ultimachine/HE280PCB/ProjectOutputs/Report Board Stack/HE280PCB_6a.xls

Board Stack Report
Stack Up |  | Layer Stack
Layer | Board Layer Stack | Name | Material | Thickness | Constant
1 |  | Top Paste, Top Paste
2 |  | Top Overlay, Top Silk
3 |  | Top Solder, Top Mask | Solder Resist | 0.40mil | 3.5
4 |  | Top Layer, Top | Copper | 1.40mil
5 |  | Dielectric 1 | FR-4 | 58.00mil | 4.8
6 |  | Bottom Layer, Bottom | Copper | 1.40mil
7 |  | Bottom Solder, Bot Mask | Solder Resist | 0.40mil | 3.5
8 |  | Bottom Overlay, Bot Silk
9 |  | Bottom Paste, Bot Paste
 | Height : 61.60mil
