ultimachine/HE280PCB/Panels/ProjectOutputs/Report Board Stack/HE280PCB-panel_v6a.xls

Board Stack Report
Stack Up |  | Layer Stack
Layer | Board Layer Stack | Name | Material | Thickness | Constant
1 |  | Top Paste
2 |  | Top Overlay
3 |  | Top Solder | Solder Resist | 0.40mil | 3.5
4 |  | Top Layer | Copper | 1.40mil
5 |  | Dielectric1 | FR-4 TG170 | 58.00mil | 4.2
6 |  | Bottom Layer | Copper | 1.40mil
7 |  | Bottom Solder | Solder Resist | 0.40mil | 3.5
8 |  | Bottom Overlay
9 |  | Bottom Paste
 | Height : 61.60mil
