ultimachine/HE280PCB/Panels/ProjectOutputs/HE280PCB-panel_v5d.PDF

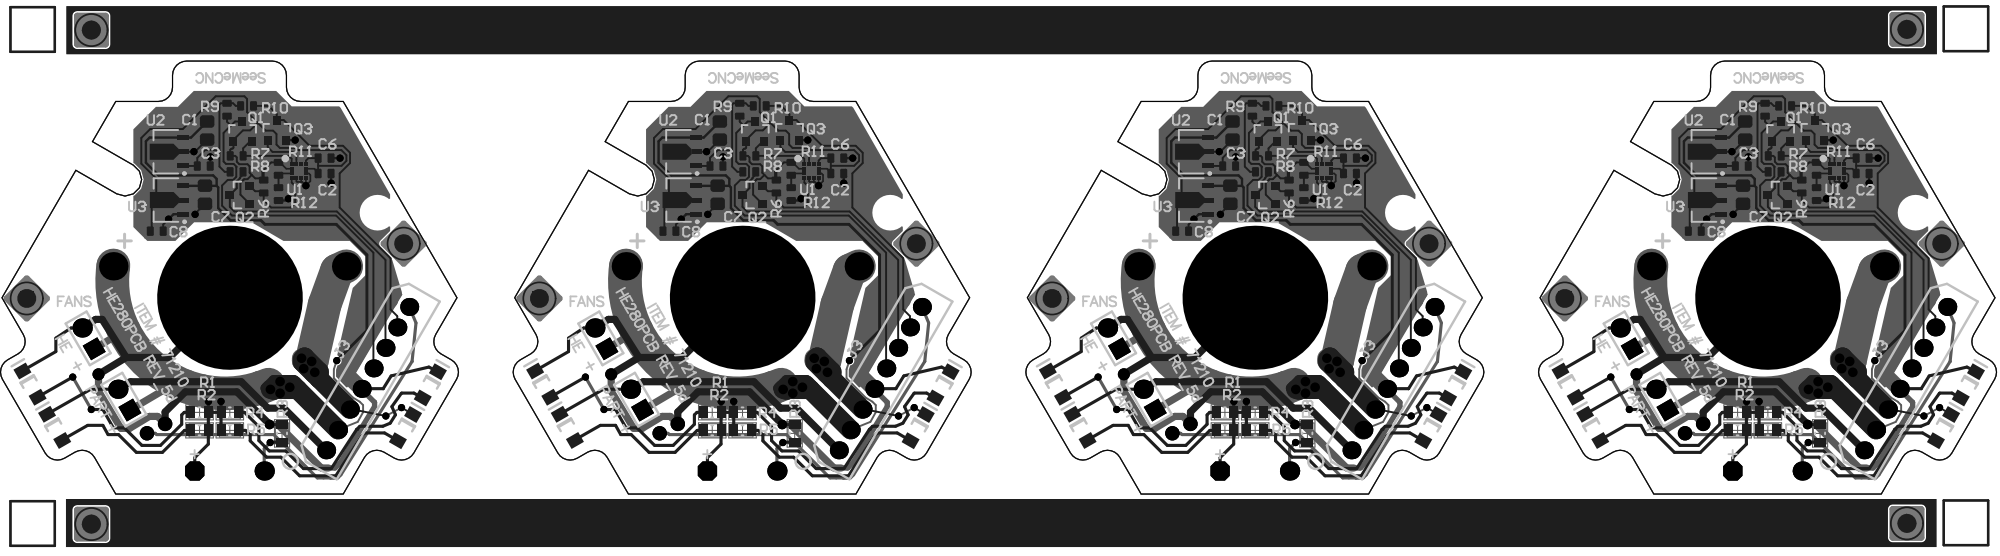
[picture p1: page 1]

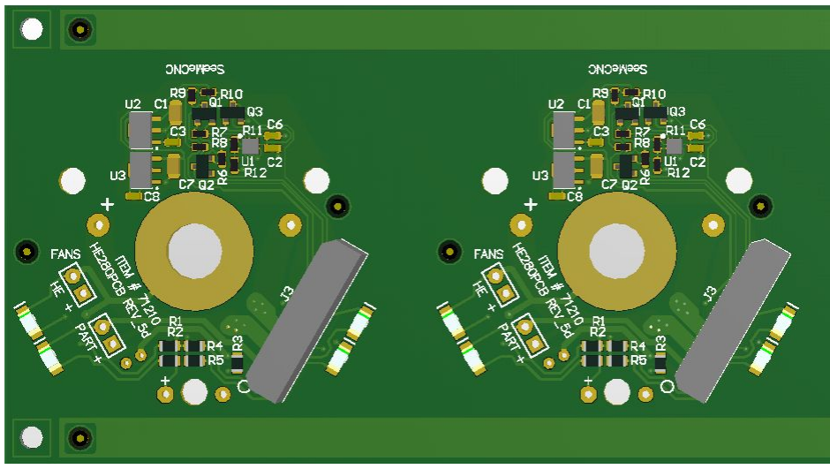
[picture p2: figure]

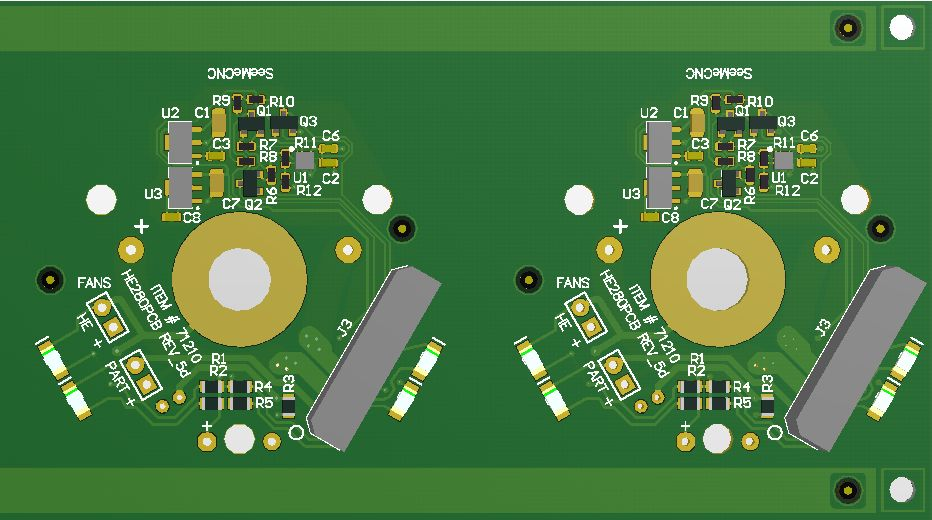
[picture p3: figure]
