ultimachine/HE280PCB/ProjectOutputs/ExportSTEP/ExportSTEP/HE280PCB.step

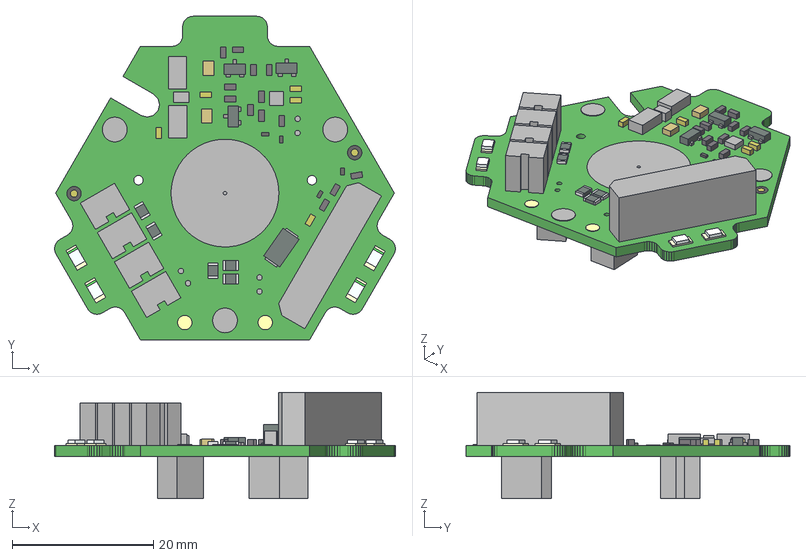
[picture p4: CAD file, 2017-08-01]
ProjectOutputs/ExportSTEP/ExportSTEP/HE280PCB.step
48.2 x 45.8 x 15.1 mm
Board
Extruded x 76
