ultimachine/HE280PCB/ProjectOutputs/ExportSTEP/HE280PCB_6a.step

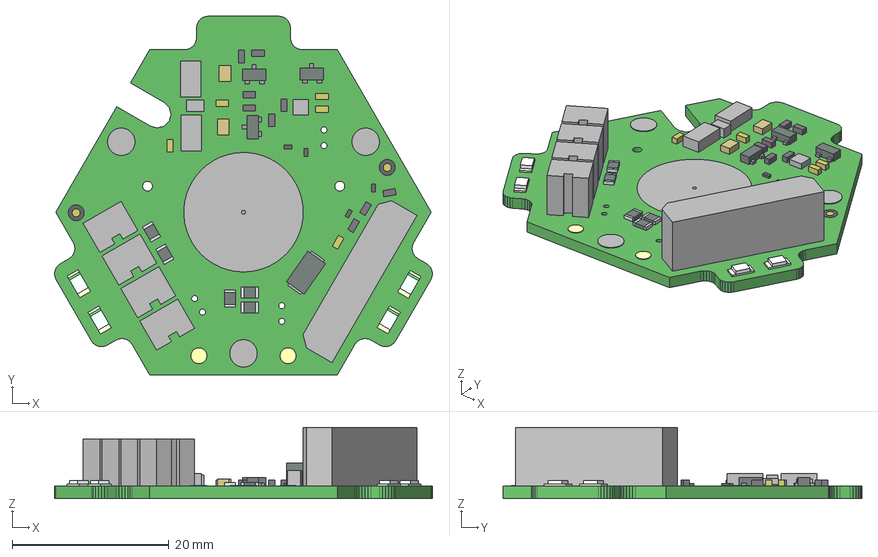
[picture p5: CAD file, 2017-07-20]
ProjectOutputs/ExportSTEP/HE280PCB_6a.step
48.2 x 45.8 x 9.08 mm
Board
Extruded x 69
