ultimachine/HE280PCB/ProjectOutputs/HE280PCB_6a_HE280PCB 5V_3Dview.PDF

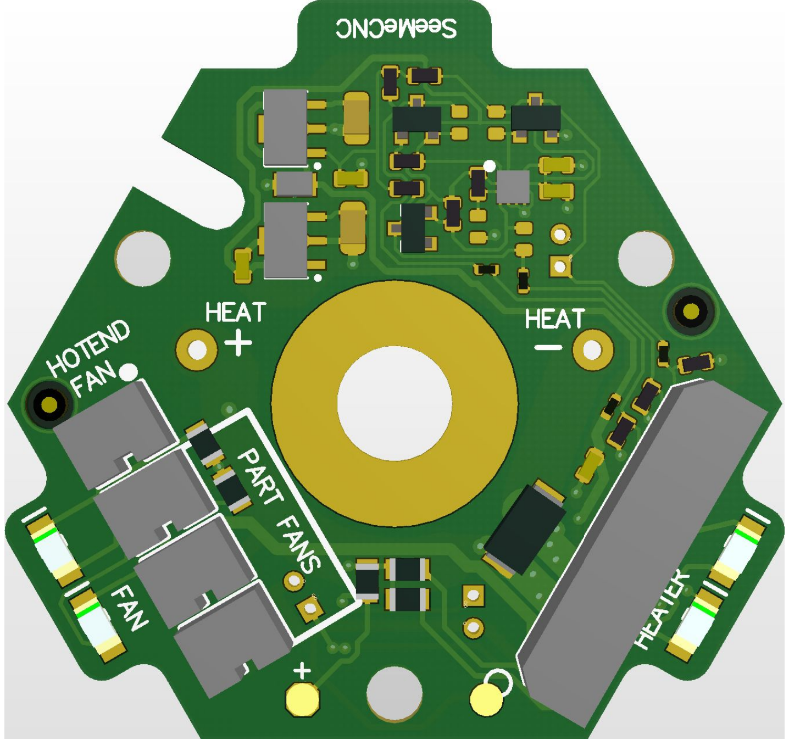
[picture p8: page 2]

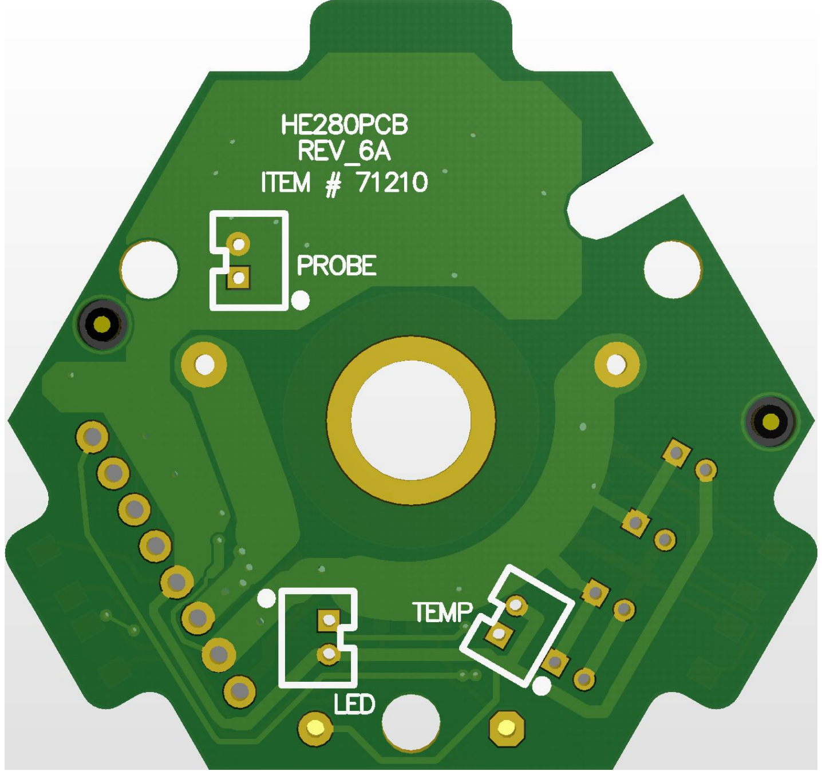
[picture p9: page 3]
