ultimachine/HE280PCB/(list of files, drawings)

Other design files:
HE280PCB.PcbDoc
HE280PCB.PcbLib
HE280PCB.PrjPcb
HE280PCB.SchDoc
Panels/HE280PCB-panel.PcbDoc
Panels/HE280PCB-panel.PrjPcb
