ultimachine/HE280PCB/(commit log)

2017-04-02 disconnect extruder hole from gnd
    [HE280PCB.PcbDoc, HE280PCB.SchDoc]
2017-05-09 change 3.3V regulator. fix sch-pcb differences
    [HE280PCB.PcbDoc, HE280PCB.PrjPcb, HE280PCB.SchDoc]
2017-07-12 Add 3.3V variant
    [HE280PCB.PcbDoc, HE280PCB.PcbLib, HE280PCB.PrjPcb, HE280PCB.SchDoc]
2017-07-12 cleanup SilkScreens
    [HE280PCB.PcbDoc, HE280PCB.PrjPcb]
2017-07-12 remove unpop connectors from variants
    [HE280PCB.PcbDoc, HE280PCB.SchDoc]
2017-07-12 regenerate outputs
    [HE280PCB_v5d.GBL, HE280PCB_v5d.GBO, HE280PCB_v5d.GBP, HE280PCB_v5d.GBS, HE280PCB_v5d.GTL, HE280PCB_v5d.GTO, HE280PCB_v5d.GTP, HE280PCB_v5d.GTS]
2017-07-12 add fan led silk
    [HE280PCB.PcbDoc]
2017-07-14 non-pop bottom side connectors both variants
    [HE280PCB.SchDoc]
2017-07-14 6a output files
    [HE280PCB_6a.GBL, HE280PCB_6a.GBO, HE280PCB_6a.GBP, HE280PCB_6a.GBS, HE280PCB_6a.GM1, HE280PCB_6a.GTL, HE280PCB_6a.GTO, HE280PCB_6a.GTP]
2017-07-16 fix ferrite footprint
    [HE280PCB.PcbDoc, HE280PCB.PrjPcb, HE280PCB.SchDoc]
2017-07-20 rotate fan connectors, add varistors, clear around holes
    [HE280PCB.PcbDoc, HE280PCB.PrjPcb, HE280PCB.SchDoc, HE280PCB.step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]
2017-08-01 add 1M gnd to HE. update led package
    [HE280PCB-panel.PrjPcb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]
